MusaAkyuz/8bit-Computer/hardware/03-revision-2023/ControlÜnitesiMalzemeler.pdf

## Bill Of Materials for ControlBlock

Design Title | ControlBlock

### Author Document Number Revision

Design Created | 02 May 2023

### Design Last Modified 02 May 2023 Total Parts In Design 44

0 Modules
Quantity | References | Value | Stock Code | Unit Cost
Sub-totals: | | | | £0.00
0 Capacitors
Quantity | References | Value | Stock Code | Unit Cost
Sub-totals: | | | | £0.00
0 Resistors
Quantity | References | Value | Stock Code | Unit Cost
Sub-totals: | | | | £0.00
44 Integrated Circuits
Quantity | References | Value | Stock Code | Unit Cost
7 | U1-U7 | NOT
9 | U8,U19-U26 | AND_5
13 | U9-U13,U16,U27-U30,U38-U40 | AND_3
2 | U14,U32 | OR_5
4 | U15,U33,U35,U43 | AND
4 | U17-U18,U31,U41 | AND_4
4 | U34,U36-U37,U44 | OR
1 | U42 | OR_4
Sub-totals: | | | | £0.00
0 Transistors
Quantity | References | Value | Stock Code | Unit Cost
Sub-totals: | | | | £0.00
0 Diodes
Quantity | References | Value | Stock Code | Unit Cost
Sub-totals: | | | | £0.00
0 Miscellaneous
Quantity | References | Value | Stock Code | Unit Cost
Sub-totals: | | | | £0.00
Totals: | | | | £0.00
| | | | 02 May 2023 13:30:44
