MusaAkyuz/8bit-Computer/docs/paper/bildiri-yedek-template.docx

8-Bit Bilgisayar Mimarisi ve Komut Seti Tasarımı ve Gerçekleştirilmesi

8-Bit Computer Architecture and Instruction Set Desing and Implementation

Musa Akyüz, Dr. Öğr. Üyesi Ümit Şentürk

Özetçe—Günümüzde, birçok işlemci üreten firma ve bu firmaların arasındaki rekabete baktığımızda hepsinin daha küçük alanda daha hızlı işler yaptıran elektronik devreler üretmeye çalıştığını görüyoruz. Bu çalışmada, nanometreler düzeyinde yapılan yarışın, büyük hale dönüştürülmüş versiyonu tanıtılmaktadır. Bu çalışma, işlemci içerisindeki mantıksal ve aritmatik hesaplama, kaydetme, giriş-çıkış ve kaydırma birimlerinin basit elektronik elemanlar ve tümleşik devreler ile tasarımını ve birimlerin birbirleriyle senkronize şekilde haberleşmesini içermektedir. Tasarlanan komut seti sayesinde bu birimlerin bit düzeyindeki işlemleri kontrol edilmektedir. 8 bit veri yollu tek vuruşluk işlemci tasarlanmıştır. Hafıza birimi işlemci içerisinde konumlandırılmıştır. Bu sayede günümüz işlemcilerinin bir dezavantajı olan hafıza biriminden veri işleme süresi ve gecikmesinin önüne geçilmeye çalışılmıştır.

Anahtar Kelimeler — bilgisayar mimarisi; komut seti; aritmatik mantık birimi; kaydedici; veri yolu tasarımı;

Abstract—This electronic document is a “live” template and already defines the components of your paper [title, text, heads, etc.] in its style sheet. *CRITICAL: Do Not Use Symbols, Special Characters, or Math in Paper Title or Abstract.

Keywords — computer architecture; ınstruction set; arithmetic logic unit; register; bus design

# I. Giriş

Tasarlanan mimaride Harward mimarisi benimsenmiştir. Harward mimarisi program belleği ile veri belleğinin farklı veri yolları ile merkezi işlem birimine bağlı olduğu mimaridir [1]. Komut ve veri bilgisi aynı anda merkezi işlem birimine gelebildiği için bir komut tek vuruşta işlenebilir [2]. Bu tasarım işlemci içersindeki veri yollarının sayısını arttırır. Bu sayede kontrol ünitesinin çok daha basit bir sistem olmasını sağlamaktadır.Benzer bir araştırmaya [3] kıyasla Tasarlanan komut seti içeriğinde, komutun kendisi ve kontrol ünitesi için kullanılacak bitler, manuel olarak veri girişi için anlık değer bitleri ve kaydediciler için adres bitleri bulunur. Her bir komut 24 bit uzunluğundadır ve tek türdür.

# II. Method

TABLO I.  24 bit komut için bit dağılımı

Komut Seti | Bit dağılımı
| 7-bit | 9-bit (3-3-3) | | | 8-bit
| Kontrol ünitesi – Komut bilgisi | HK | KK1 | KK2 | Anlık değer

a. HK: Hedef Kaydedici Adresi, KK: Kaynak Kaydedici Adresi

Tablo 1’de de görüleceği üzere 7-bit ile komut tespiti yapılmıştır. Tasarlanan mimaride 2^7 yani 128 farklı komut çalıştırılabilir. Şimdilik, 28 farklı temel komut oluşturulmuştur.

TABLO II.  Aritmatik- Mantıksal Komutlar

Komut Türleri | Komutlar
Aritmatik Komutlar | ADD, ADDIMM, SUB, SUBIMM
Mantıksal Komutlar | AND ANDIMM, OR, ORIMM

Tablo 2 de 4 adet aritmatik işlem ve 4 adet de mantıksal işlem komutları bulunmaktadır. Aritmatikler sırasıyla toplama, anlık ile toplama, çıkarma, anlık ile çıkarma, ve işlemidir. Mantıksa komutlar sırasıyla ve, anlık ile ve, veya, anlık ile veya işlemidir.

Örnek olarak; kaynak kaydedi 2 (adresi 010) içerisinde 8 bit uzunluğunda 125 verisini tutsun. Hedef kaydedici 5 (adresi 101) de üzerinde 8 bit ile 12 bilgisini tutsun. Bu iki veriyi aritmatik mantık birimindeki toplayıcı devre üzerinde toplayıp çıkışı 1 nolu kaydediciye (adresi 001) kaydedeceği bir senaryo olsun. Program belleğinden ADD komutu (komut kodu 0000001) bu bilgilerle birlikte şu şekilde gelecektir.

000000100101010100000000

Anlık

değer

KY2

KY1

HY

Komut kodu

TABLO III.  Kaydırma

Komut Türleri | Komutlar
Kaydırma | SHIFTLEFT, SHIFTRIGHT

Tablo 3 de birer bit sola ve sağa kaydırma komutları görülür. Tasarlanan komut setinde birden çok kaydırma adımı içiren bir sistem olması durumunda bu komutlar ard arda çalışacaktır.

TABLO IV.  Kaydedici kayıt

Komut Türleri | Komutlar
Anlık değerden alma | LBFROMIMM
Bellekten alma | LBFROMMEM
Başka bir kaydediciden alma | REGTOREG

Tablo 4 deki komutlar, kaydedicilere ilk değer atanırken veya bellekten çekilen verinin kaydedicilere geçirilmesi esnasında kullanılırlar.

Örnek olarak; 5 nolu kaydediciden (adresi 101) 2 numaralı kaydediciye (adresi 010) içerisindeki veriyi kaydetmek isteyelim. Bu bilgilerle birlikte REGTOREG komutu (komut kodu 0001101) şu şekilde yazılır.

000110110100001000000000

TABLO V.  Hafıza işlemleri

Komut Türleri | Komutlar
Kayıt etme | SBFROMIMM, SBFROMREG

Tabla 5 deki komutlar anlık değerden veya kaydediciden aldığı bellekteki adres bilgisine, yine anlık değerden veya kaydediciden aldığı bilgiyi kaydeder.

TABLO VI.  Dallanma komutları

Komut Türleri | Komutlar
Dallanma | BEQ, BNE, BLT, BGT, BGE, BLE

Tablo 6 daki komutlar, program devam ederken gelen atlama işlemi komutlarıdır. Bu komutlar iki kaydedicinin verisini karşılaştıraraki büyüklük, küçüklük ve eşitlik durumlarına göre program sayacının akışını değiştirirler. Bu sayede programda döngü yazılabilir hale gelir.

Tablo 7 de ise giriş çıkış için kullanılacak komutlar vardır. Herhangi bir kaydedicideki veya bellekteki bir veriyi, farklı adresleme metodları ile çıkış ünitesine gönderen komutların yanı sıra, giriş olarak işleyen ve kaydeden komutlardır.

TABLO VII.  Giriş – Çıkış komutları

Komut Türleri | Komutlar
Çıkış | PRINTREG, PRINTREGANDLOAD, PRINTMEMFROMREG, PRINTMEMFROMIMM
Giriş | WRITETOREG, WRITETIMEMFROMREG, WRITETIMEMFROMIMM


Figure. 1. Advanced diagram to design

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

Program sayıcıda hesaplanan komut adresi, komut belleğinde bulunan 3 farklı 8 bit adreslenebilir belleklerin adres seçim pinleri ile bağlanır. Burada 3 farklı bellek kullanımının amacı, paralel veri yolu sistemini korumak ve kontrol unitesinin karmaşıklığını azaltmaktır (Bkz Figure 2).


Figure. 2. Program Memory Split Structure Basic Schema

Bu [4] yazıda bahsi geçen Single Instruction Multiple Data Stream yaklaşımı gibi program sayacı ile birden çok bellekden (SIMD) veri çıkışı kontrol edilmiştir.


Figure. 3. Input-Output design

Figure 3 deki resimde görüleceği üzere, giriş çıkış ünitesi doğrudan tasarlanan işlemcinin içindeki ortak veri yoluna bağlıdır. Kontrol ünitesinden gelen giriş veya çıkış işlemleri sırasında bu veri yollarından veri çekere veya veriyi aktarır.

# III. Kullanım

## A. Taslak seçmek (*Heading 2)

Doğru taslağı (bu taslağı) kullandığınızdan emin olunuz.

## B. Taslağın formatına bağlı kalmak

Taslağın formatını değiştirmeyiniz. Bu yayın tek başına bir doküman değildir, bir derginin parçası olarak basılacaktır.

# IV. Sayfa Düzeni ve Biçim

Düzenlemeye başlamadan önce tüm çalışmanızı ayrı bir dosya olarak kayıdetmeniz tavsiye edilir. Ayrıca düzenleme sonuçlanıncaya kadar grafik ve şekilleri düz yazıdan ayrı tutmanız faydalı olacaktır. Çalışmanın herhangi bir noktasında sayfa numaralandırması yapılmamalıdır. Taslak içerisinde başlıklar numaralandırılacağından ayrıca sizin numaralandırmanıza gerek yoktur. Sayfa düzenlenirken aşağıdaki kurallara uyulmalıdır. Hazır bir taslak (Word ya da LaTeX) kullanmanız veya ayrıntıların kontrolü için örnek bir dosya takip etmeniz, bu gereklilikleri yerine getirmeniz açısından önerilir.

İlgili bölümlerde kullanılması gereken stiller parantez içerisinde eğik yazı ile belirtilmiştir, ”(*kullanılacak stil)” şeklinde. Bu ifadeler sadece bilgilendirme amaçlıdır, metnin son halinde bulunmamalıdır.

## A. Kısaltmalar

Kısaltmaları yazı içinde ilk defa kullanıldıklarında tanımlayınız. Başlıklarda kısaltma kullanmayınız. IEEE, SI, CGS vb. gibi çok bilinmiş kısaltmaları tanımlamanıza gerek yoktur.

## B. Birimler

- SI veya CGS ölçüm birimlerini kullanınız. (SI ölçüm birimi tavsiye edilir.)
- Yazı içinde farklı ölçüm birimleri kullanmayınız. İngiliz ölçüm birimlerini birinci birim olarak kullanmaktan kaçınınız. Ancak çok gerekli ise parantez içerisinde ikinci birim olarak gösteriniz.
- Ölçüm birimlerini yazarken tutarlılık sağlayınız. Örneğin “Wb/m²” veya “webers per square meter” kullanınız, “webers/m²” kullanmayınız.
- Küsuratlı sayı kullanırken “.25” yerine “0.25” kullanınız.

## C. Denklemler

Denklemler taslaktaki formata istisnadır. “Times New Roman” veya “Symbol” yazı tipini kullanınız. Çok seviyeli denklemleri resim olarak yazıya yerleştiriniz.

Denklemler aşağıdaki örneğe benzemelidir. Denklemler için “*equation” stilini kullanınız.

ab

Denklem merkezde olmalıdır. Denklemdeki sembolleri tanımladığınızdan emin olunuz. Denklemden bahsederken “(1)” kullanınız. Cümle başında “Denklem (1)” kullanabilirsiniz.

# V. Taslağı Kullanmak

## A. Yazarlar

Yayının yazarları bildiri kabulünden sonra gönderilecek son halinde bu taslağın başında “Yazarlar Gizlenmiştir” ibaresinin olduğu yerde belirtilecek ve yazar, kurum ve iletişim bilgileri bu ibarenin alt satırlarında belirtilecektir. Aynı kurumda çalışan yazarları sırf farklı bölümde çalışıyorlar diye farklı olarak belirtmeye gerek olmayacaktır. **Ancak bildirinin ilk gönderilecek halinde yazarların kimliğini açığa çıkarıcı hiçbir bilgi bulunmamalıdır.

## B. Başlıklar

Bölüm başlıkları için “Başlık 1 (Heading 1)” kullanınız. Şekiller için “şekil başlığı (figure caption)”, tablolar için ise “Tablo Başlığı (table head)” kullanınız.

Eğer birden fazla alt konu yoksa alt konu başlığı kullanmayınız.

## C. Şekil ve Tablolar

### 1) Şekil ve tabloların yerleştirilmeleri: (*Heading 3) Şekilleri ve tabloları metinde isimleri geçtikten sonra sütun başına veya sonuna yerleştiriniz. Şekil başlığını şeklin altına, tablo başlığını ise tablonun üstüne yerleştiriniz. Tablo örneği Tablo 1’de ve şekil örneği Şekil 1’de gösterilmiştir.

### 2) Aksis tanımlamaları: 8 büyüklüğünde punto kullanınız. Kısaltma kullanmayınız. Birim ekleyecekseniz “Sıcaklık/K” değil, “Sıcaklık (K)” şeklinde olmalıdır.

Şekil. 1. Şekil örneği. (*figure caption)

Şekillerin bir metin dosyasının içinde olması dosyanın daha kararlı olmasını sağladığı gözlenmiştir. (Bir görselin ideal olarak 300dpi çözünürlüklü TIFF veya EPS dosyası olması ve bütün yazı tiplerinin gömülü olması beklenmektedir.)

Metin kutusunun “Renk ve Çizgi” ayarlarından çerçeve renksiz ve çizgisiz hale getirilebilir.

TABLO VIII.  Örnek Tablo (*table head)

Tablo Başlığı | Tablo Sütun Başlığı
| Tablo sütun ara başlığıa | Ara başlık | Ara başlık

b. Tablo dipnotu örneği. (*table footnote)

##### Bilgilendirme

Bilgilendirmeler gizlenmiştir.

##### Kaynaklar

[1] Pizhou Ye and Chaodong Ling, "A RISC CPU IP core," 2008 2nd International Conference on Anti-counterfeiting, Security and Identification, 2008, pp. 356-359, doi: 10.1109/IWASID.2008.4688427.
[2] Reaz, M. I., Jalil, J., & Rahman, L. F. (2012). Single core hardware modeling of 32-bit MIPS RISC processor with a single clock. Research Journal of Applied Sciences, Engineering and Technology, 4(7), 825-832.
[3] Özkurt, N. E. & Gündüzalp, M. (2000). 8 BİT GENEL AMAÇLI BİR MİKRODENETLEYİCİNİN ÇOK BÜYÜK ÖLÇEKLİ TÜMLEŞİK DEVRE TEKNOLOJİSİ İLE TASARIMI . Dokuz Eylül Üniversitesi Mühendislik Fakültesi Fen ve Mühendislik Dergisi , 2 (2) , 1-14 . Retrieved from https://dergipark.org.tr/tr/pub/deumffmd/issue/40893/493747
[4] Flynn, Michael J., and Kevin W. Rudd. "Parallel architectures." ACM computing surveys (CSUR) 28.1 (1996): 67-70.
[5] Rudnicky, A. I., Polifroni, Thayer, E H., and Brennan, R. A. "Interactive problem solving with speech", J. Acoust. Soc. Amer., Vol. 84, 1988, p S213(A).
