MusaAkyuz/8bit-Computer/docs/design/komutseti.ods

 |  |  | 7 BİT | 3BİT | 3 BİT |  | 3 BİT |  | 8 BİT
 | Komut | Açıklama | Kontrol Ünitesi Kodu | HY | KY1 |  | KY2 |  | Anlık Değer | Açıklama
1 | ADD | İki kaydedicideki veriyi toplar | 0000001 | √ | √ |  | √ |  | X | HY = KY1 + KY2
2 | ADDIMM | Bir kaydedicideki veri ile anlık değeri toplar | 0000010 | √ | √ |  | X |  | √ | HY = KY1 + ANLIK
3 | SUB | İki kaydedicideki veriyi çıkarır | 0000011 | √ | √ |  | √ |  | X | HY = KY1 – KY2
4 | SUBIMM | Bir kaydedicideki veriden anlık değeri çıkarır | 0000100 | √ | √ |  | X |  | √ | HY = KY1 – ANLIK
5 | AND | İki kaydedicideki verileri VE işlemine sokar | 0000101 | √ | √ |  | √ |  | X | HY = KY1 && KY2
6 | ANDIMM | Bir kaydedicideki veri ile anlık değeri VE işlemine sokar | 0000110 | √ | √ |  | X |  | √ | HY = KY1 && ANLIK
7 | OR | İki kaydedicideki verileri VEYA işlemine sokar | 0000111 | √ | √ |  | √ |  | X | HY = KY1 || KY2
8 | ORIMM | Bir kaydedicideki veri ile anlık değeri VEYA işlemine sokar | 0001000 | √ | √ |  | X |  | √ | HY = KY1 || ANLIK
9 | SHIFTLEFT | Bir kaydedicideki veriyi bir BİT sola kaydırır | 0001001 | √ | KAYDEDİCİ3 |  | X |  | X | HY = KY1[0:6]
10 | SHIFTRIGHT | Bir kaydedicideki veriyi bir BİT sağa kaydırı | 0001010 | √ | KAYDEDİCİ 3 |  | X |  | X | HY = KY1[1:7]
11 | LBFROMIMM | Anlık değerden aldığı veriyi hedef kaydediciye yükler | 0001011 | √ | X |  | X |  | √ | HY = ANLIK
12 | LBFROMMEM | Hafızadan aldığı veriyi hedef kaydediciye yükler, Hafıza adreslerken anlık değeri kullanır | 0001100 | √ | X |  | X |  | √ | HY = MEM(ANLIK)
13 | REGTOREG | Bir kaydedicideki veriyi başka bir kaydediciye aktarır, yükler | 0001101 | √ | √ | X | X | √ | X | HY = KY
14 | SBFROMIMM | Bir kaydedicideki veriyi adres olarak kullanır ve hafıza birimine anlık değeri yazar | 0001110 | X | √ | X | X | √ | √ | MEM(KY) = ANLIK
15 | SBFROMREG | Anlık değerdeki veriyi adres olarak kullanır ve hafıza birimine kaydedicideki veriyi yazar | 0001111 | X | √ | X | X | √ | √ | MEM(ANLIK) = KY
16 | BEQ | İki kaydedicideki verinin eşit olma durumunu karşılaştırır. Eğer eşitse anlık değer kadar komut atlar | 0010000 | X | √ |  | √ |  | √ | IF KY1 == KY2 JUMP ANLIK
17 | BNE | İki kaydedicideki verinin eeşit olmama durumunu karşılaştırır. Eşit değilse anlık değer kadar komut atlar | 0010001 | X | √ |  | √ |  | √ | IF KY1 != KY2 JUMP ANLIK
18 | BLT | Birinci kaydedicideki verinin ikinci kaydedicideki veriden küçük olma durumunu karşılaştırır. Eğer büyükse, anlık değer kadar komut atlar | 0010010 | X | √ |  | √ |  | √ | IF KY1 < KY2 JUMP ANLIK
19 | BGT | Birinci kaydedicideki verinin ikinci kaydedicideki veriden büyük olma durumunu karşılaştırır. Eğer büyükse, anlık değer kadar komut atlar | 0010011 | X | √ |  | √ |  | √ | IF KY1 > KY2 JUMP ANLIK
20 | BGE | Birinci kaydedicideki verinin ikinci kaydedicideki veriden büyük ve eşit olma durumunu karşılaştırır. Eğer büyük ve eşitse, anlık değer kadar komut atlar | 0010100 | X | √ |  | √ |  | √ | IF KY1 >= KY2 JUMP ANLIK
21 | BLE | Birinci kaydedicideki verinin ikinci kaydedicideki veriden küçük ve eşit olma durumunu karşılaştırır. Eğer kü.ük ve eşit ise, anlık değer kadar komut atlar | 0010101 | X | √ |  | √ |  | √ | IF KY1 <= KY2 JUMP ANLIK
22 | PRINTREG | Bir kaydedicideki veriyi çıkış birimine gönderir | 0010110 | X | √ | X | X | √ | X | OUTPUT(KY)
23 | PRINTREGANDLOAD | Bir kaydedicideki veriyi çıkış birimine gönderir ve başka bir kaydediciye yükler | 0010111 | √ | √ | X | X | √ | X | HY = OUTPUT(KY)
24 | PRINTMEMFROMREG | Bir kaydedicideki veriyi adres olarak kullanır ve hafıza birimine gönderir. O adresdeki veriyi çıkış birimine gönderir | 0011000 | X | √ | X | X | √ | X | OUTPUT(MEM(KY))
25 | PRINTMEMFROMIMM | Anlık değeri adres olarak kullanır ve hafıza birimine gönderir. O adresdeki veriyi çıkış birimine gönderir | 0011001 | X | X |  | X |  | √ | OUTPUT(MEM(ANLIK))
26 | WRITETOREG | Giriş biriminden gelen veriyi bir kaydediciye yükler | 0011010 | √ | X |  | X |  | X | HY = INPUT
27 | WRITETOMEMFROMREG | Bir kaydedicideki veriyi adres olarak kullanır ve giriş biriminden gelen veriyi hafıza birimine yükler | 0011011 | X | √ | X | X | √ | X | MEM(KY) = INPUT
28 | WRITETOMEMFROMIMM | Anlık değerden aldığı veriyi adres olarak kullanır ve giriş biriminden aldığı veriyi hafıza birimine yükler | 0011100 | X | X |  | X |  | √ | MEM(ANLIK) = INPUT
