MusaAkyuz/8bit-Computer/docs/images/proteus-overview.png

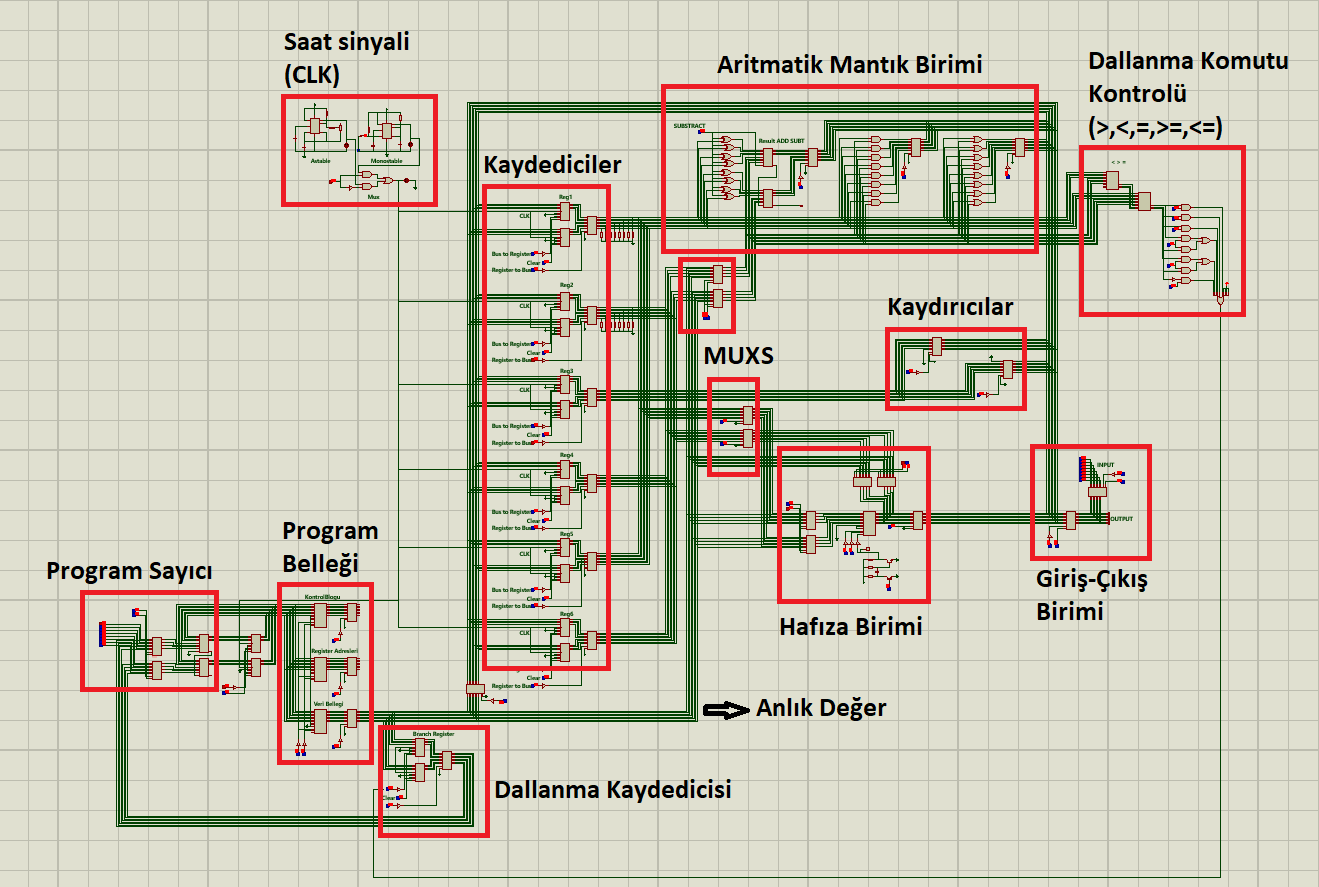
docs/images/proteus-overview.png
