MusaAkyuz/8bit-Computer/docs/images/reference-avr-arithmetic.png

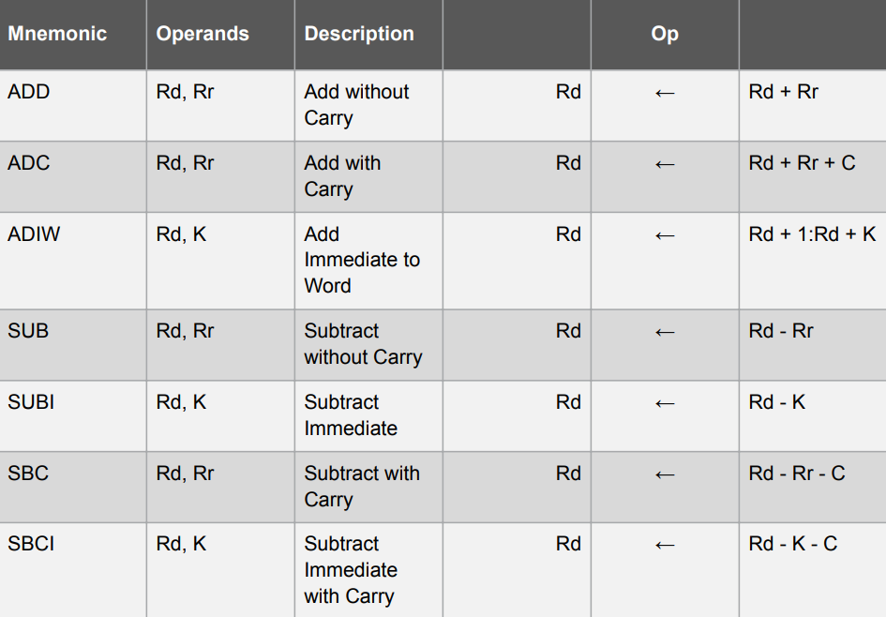
docs/images/reference-avr-arithmetic.png
