MusaAkyuz/8bit-Computer/docs/images/reference-intel-8080.png

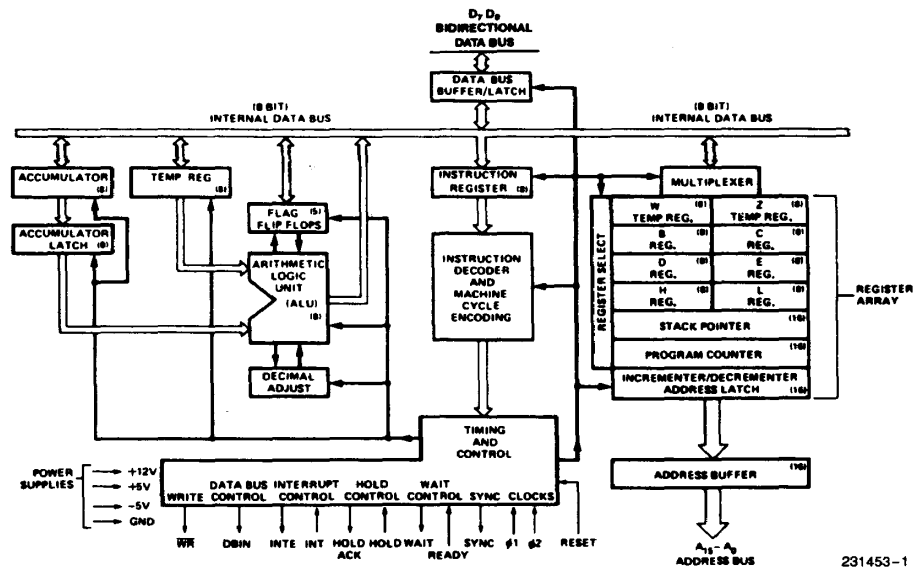
docs/images/reference-intel-8080.png
