MusaAkyuz/8bit-Computer/docs/design/komutseti-aktarma.xlsx

Sheet: Komut_Seti_V1
 |  |  | 7 BİT | 3BİT | 3 BİT |  | 3 BİT |  | 8 BİT
 | Komut | Açıklama | Kontrol Ünitesi Kodu | HY | KY1 |  | KY2 |  | Anlık Değer | Açıklama
1 | ADD | İki kaydedicideki veriyi toplar | 0000001 | √ | √ |  | √ |  | X | HY = KY1 + KY2
2 | ADDIMM | Bir kaydedicideki veri ile anlık değeri toplar | 0000010 | √ | √ |  | X |  | √ | HY = KY1 + ANLIK
3 | SUB | İki kaydedicideki veriyi çıkarır | 0000011 | √ | √ |  | √ |  | X | HY = KY1 – KY2
4 | SUBIMM | Bir kaydedicideki veriden anlık değeri çıkarır | 0000100 | √ | √ |  | X |  | √ | HY = KY1 – ANLIK
5 | AND | İki kaydedicideki verileri VE işlemine sokar | 0000101 | √ | √ |  | √ |  | X | HY = KY1 && KY2
6 | ANDIMM | Bir kaydedicideki veri ile anlık değeri VE işlemine sokar | 0000110 | √ | √ |  | X |  | √ | HY = KY1 && ANLIK
7 | OR | İki kaydedicideki verileri VEYA işlemine sokar | 0000111 | √ | √ |  | √ |  | X | HY = KY1 || KY2
8 | ORIMM | Bir kaydedicideki veri ile anlık değeri VEYA işlemine sokar | 0001000 | √ | √ |  | X |  | √ | HY = KY1 || ANLIK
9 | SHIFTLEFT | Bir kaydedicideki veriyi bir BİT sola kaydırır | 0001001 | √ | KAYDEDİCİ3 |  | X |  | X | HY = KY1[0:6]
10 | SHIFTRIGHT | Bir kaydedicideki veriyi bir BİT sağa kaydırı | 0001010 | √ | KAYDEDİCİ 3 |  | X |  | X | HY = KY1[1:7]
11 | LBFROMIMM | Anlık değerden aldığı veriyi hedef kaydediciye yükler | 0001011 | √ | X |  | X |  | √ | HY = ANLIK
12 | LBFROMMEM | Hafızadan aldığı veriyi hedef kaydediciye yükler, Hafıza adreslerken anlık değeri kullanır | 0001100 | √ | X |  | X |  | √ | HY = MEM(ANLIK)
13 | REGTOREG | Bir kaydedicideki veriyi başka bir kaydediciye aktarır, yükler | 0001101 | √ | √ | X | X | √ | X | HY = KY
14 | SBFROMIMM | Bir kaydedicideki veriyi adres olarak kullanır ve hafıza birimine anlık değeri yazar | 0001110 | X | √ | X | X | √ | √ | MEM(KY) = ANLIK
15 | SBFROMREG | Anlık değerdeki veriyi adres olarak kullanır ve hafıza birimine kaydedicideki veriyi yazar | 0001111 | X | √ | X | X | √ | √ | MEM(ANLIK) = KY
16 | BEQ | İki kaydedicideki verinin eşit olma durumunu karşılaştırır. Eğer eşitse anlık değer kadar komut atlar | 0010000 | X | √ |  | √ |  | √ | IF KY1 == KY2 JUMP ANLIK
17 | BNE | İki kaydedicideki verinin eeşit olmama durumunu karşılaştırır. Eşit değilse anlık değer kadar komut atlar | 0010001 | X | √ |  | √ |  | √ | IF KY1 != KY2 JUMP ANLIK
18 | BLT | Birinci kaydedicideki verinin ikinci kaydedicideki veriden küçük olma durumunu karşılaştırır. Eğer büyükse, anlık değer kadar komut atlar | 0010010 | X | √ |  | √ |  | √ | IF KY1 < KY2 JUMP ANLIK
19 | BGT | Birinci kaydedicideki verinin ikinci kaydedicideki veriden büyük olma durumunu karşılaştırır. Eğer büyükse, anlık değer kadar komut atlar | 0010011 | X | √ |  | √ |  | √ | IF KY1 > KY2 JUMP ANLIK
20 | BGE | Birinci kaydedicideki verinin ikinci kaydedicideki veriden büyük ve eşit olma durumunu karşılaştırır. Eğer büyük ve eşitse, anlık değer kadar komut atlar | 0010100 | X | √ |  | √ |  | √ | IF KY1 >= KY2 JUMP ANLIK
21 | BLE | Birinci kaydedicideki verinin ikinci kaydedicideki veriden küçük ve eşit olma durumunu karşılaştırır. Eğer kü.ük ve eşit ise, anlık değer kadar komut atlar | 0010101 | X | √ |  | √ |  | √ | IF KY1 <= KY2 JUMP ANLIK
22 | PRINTREG | Bir kaydedicideki veriyi çıkış birimine gönderir | 0010110 | X | √ | X | X | √ | X | OUTPUT(KY)
23 | PRINTREGANDLOAD | Bir kaydedicideki veriyi çıkış birimine gönderir ve başka bir kaydediciye yükler | 0010111 | √ | √ | X | X | √ | X | HY = OUTPUT(KY)
24 | PRINTMEMFROMREG | Bir kaydedicideki veriyi adres olarak kullanır ve hafıza birimine gönderir. O adresdeki veriyi çıkış birimine gönderir | 0011000 | X | √ | X | X | √ | X | OUTPUT(MEM(KY))
25 | PRINTMEMFROMIMM | Anlık değeri adres olarak kullanır ve hafıza birimine gönderir. O adresdeki veriyi çıkış birimine gönderir | 0011001 | X | X |  | X |  | √ | OUTPUT(MEM(ANLIK))
26 | WRITETOREG | Giriş biriminden gelen veriyi bir kaydediciye yükler | 0011010 | √ | X |  | X |  | X | HY = INPUT
27 | WRITETOMEMFROMREG | Bir kaydedicideki veriyi adres olarak kullanır ve giriş biriminden gelen veriyi hafıza birimine yükler | 0011011 | X | √ | X | X | √ | X | MEM(KY) = INPUT
28 | WRITETOMEMFROMIMM | Anlık değerden aldığı veriyi adres olarak kullanır ve giriş biriminden aldığı veriyi hafıza birimine yükler | 0011100 | X | X |  | X |  | √ | MEM(ANLIK) = INPUT

Sheet: Komut_Seti_V2
 |  |  | 7 BİT | 3BİT | 3 BİT | 3 BİT | 8 BİT
 | Komut | Açıklama | Kontrol Ünitesi Kodu | HY | KY1 | KY2 | Anlık Değer | Açıklama
1 | ADD | İki kaydedicideki veriyi toplar | 0000001 | √ | √ | √ | X | HY = KY1 + KY2
2 | ADDIMM | İlk kaydedicideki veri ile anlık değeri toplar | 0000010 | √ | √ | X | √ | HY = KY1 + ANLIK
3 | SUB | İlk kaydediciden ikinci kaydediciyi çıkarır. | 0000011 | √ | √ | √ | X | HY = KY1 – KY2
4 | SUBIMM | İlk kaydedicideki veriden anlık değeri çıkarır | 0000100 | √ | √ | X | √ | HY = KY1 – ANLIK
5 | AND | İki kaydedicideki verileri VE işlemine sokar | 0000101 | √ | √ | √ | X | HY = KY1 && KY2
6 | ANDIMM | İlk kaydedicideki veri ile anlık değeri VE işlemine sokar | 0000110 | √ | √ | X | √ | HY = KY1 && ANLIK
7 | OR | İki kaydedicideki verileri VEYA işlemine sokar | 0000111 | √ | √ | √ | X | HY = KY1 || KY2
8 | ORIMM | İki kaydedicideki veri ile anlık değeri VEYA işlemine sokar | 0001000 | √ | √ | X | √ | HY = KY1 || ANLIK
9 | SHIFTLEFT | İlk kaydedicideki veriyi bir BİT sola kaydırır | 0001001 | √ | √ | X | X | HY = KY1[0:6]
10 | SHIFTRIGHT | İlk kaydedicideki veriyi bir BİT sağa kaydırı | 0001010 | √ | √ | X | X | HY = KY1[1:7]
11 | IMMTOREG | Anlık değerden aldığı veriyi hedef kaydediciye yükler | 0001011 | √ | X | X | √ | HY = ANLIK
12 | MEMTOREG | Hafızadan aldığı veriyi hedef kaydediciye yükler, Hafıza adreslerken anlık değeri kullanır | 0001100 | √ | X | X | √ | HY = MEM(ANLIK)
13 | REGTOREG | İkinci kaydedicideki veriyi hedef kaydediciye aktarır | 0001101 | √ | X | √ | X | HY = KY2
14 | REGTOMEM | Anlık değerdeki veriyi adres olarak kullanır ve hafıza birimine ikinci kaydedicideki veriyi yazar | 0001110 | X | √ | X | √ | MEM(ANLIK) = KY2
15 | BEQ | İki kaydedicideki verinin eşit olma durumunu karşılaştırır. Eğer eşitse anlık değer kadar komut atlar | 0001111 | X | √ | √ | √ | IF KY1 == KY2 JUMP ANLIK
16 | BNE | İki kaydedicideki verinin eeşit olmama durumunu karşılaştırır. Eşit değilse anlık değer kadar komut atlar | 0010000 | X | √ | √ | √ | IF KY1 != KY2 JUMP ANLIK
17 | BLT | Birinci kaydedicideki verinin ikinci kaydedicideki veriden küçük olma durumunu karşılaştırır. Eğer büyükse, anlık değer kadar komut atlar | 0010001 | X | √ | √ | √ | IF KY1 < KY2 JUMP ANLIK
18 | BGT | Birinci kaydedicideki verinin ikinci kaydedicideki veriden büyük olma durumunu karşılaştırır. Eğer büyükse, anlık değer kadar komut atlar | 0010010 | X | √ | √ | √ | IF KY1 > KY2 JUMP ANLIK
19 | BGE | Birinci kaydedicideki verinin ikinci kaydedicideki veriden büyük ve eşit olma durumunu karşılaştırır. Eğer büyük ve eşitse, anlık değer kadar komut atlar | 0010011 | X | √ | √ | √ | IF KY1 >= KY2 JUMP ANLIK
20 | BLE | Birinci kaydedicideki verinin ikinci kaydedicideki veriden küçük ve eşit olma durumunu karşılaştırır. Eğer kü.ük ve eşit ise, anlık değer kadar komut atlar | 0010100 | X | √ | √ | √ | IF KY1 <= KY2 JUMP ANLIK
21 | PRINTREG | İkinci kaydedicideki veriyi çıkış birimine gönderir | 0010101 | X | X | √ | X | OUTPUT(KY2)
22 | IMMTOPRINTMEM | Anlık değeri adres olarak kullanır ve hafıza birimine gönderir. O adresdeki veriyi çıkış birimine gönderir | 0010110 | X | X | X | √ | OUTPUT(MEM(ANLIK))
23 | WRITEREG | Giriş biriminden gelen veriyi bir kaydediciye yükler | 0010111 | √ | X | X | X | HY = INPUT
24 | IMMTOWRITEMEM | Anlık değerden aldığı veriyi adres olarak kullanır ve giriş biriminden aldığı veriyi hafıza birimine yükler | 0011000 | X | X | X | √ | MEM(ANLIK) = INPUT
25 | CLEARALLREG | Tüm kaydedicilerin verilerini sıfırlar | 0011001 | X | X | X | X | ALLREG = 0
26 | CLEARSPECREG | İlgili kaydedicinin verisini siler | 0011010 | X | √ | X | X | REG = 0
 |  | İlk Kaydedici -> KY1
 |  | İkinci Kaydedici -> KY2
 |  | Hedef Kaydedici -> HY

Sheet: KARNOUGH_V1
Kaurnaugh Map | Counter | Branch Register |  | Immediatelly to Register | MUX1 REGTOIMM | MUX2 REGTOIMM2 |  | ALU |  |  |  |  |  |  |  |  |  |  |  | Memory |  |  | Memory Buffer |  | In/Out
Command/Inputs | SLC | E | BUFFBRNC | ITR | REGTOIMM1 | REFTOIMM2 | E-MEM-D | ADD/SUBB | BUFFADD/SUB | BUFAND | BUFOR | BUFSR | BUFSL | LESS | EQ | BIGGER | LESSEQ | BIGEQ | NOTEQ | E | R | W | MIN/MOUT | Enable Buf. | EnableIn | LCD/D
ADD | 0 | 0 | 0 | 0 | 0 | X | X | 0 | 1 | 0 | 0 | 0 | 0 | 0 | 0 | 0 | 0 | 0 | 0 | 0 | X | X | X | 0 | 0 | 1
ADDIMM | 0 | 0 | 0 | 0 | 1 | X | X | 0 | 1 | 0 | 0 | 0 | 0 | 0 | 0 | 0 | 0 | 0 | 0 | 0 | X | X | X | 0 | 0 | 1
SUB | 0 | 0 | 0 | 0 | 0 | X | X | 1 | 1 | 0 | 0 | 0 | 0 | 0 | 0 | 0 | 0 | 0 | 0 | 0 | X | X | X | 0 | 0 | 1
SUBIMM | 0 | 0 | 0 | 0 | 1 | X | X | 1 | 1 | 0 | 0 | 0 | 0 | 0 | 0 | 0 | 0 | 0 | 0 | 0 | X | X | X | 0 | 0 | 1
AND | 0 | 0 | 0 | 0 | 0 | X | X | X | 0 | 1 | 0 | 0 | 0 | 0 | 0 | 0 | 0 | 0 | 0 | 0 | X | X | X | 0 | 0 | 1
ANDIMM | 0 | 0 | 0 | 0 | 1 | X | X | X | 0 | 1 | 0 | 0 | 0 | 0 | 0 | 0 | 0 | 0 | 0 | 0 | X | X | X | 0 | 0 | 1
OR | 0 | 0 | 0 | 0 | 0 | X | X | X | 0 | 0 | 1 | 0 | 0 | 0 | 0 | 0 | 0 | 0 | 0 | 0 | X | X | X | 0 | 0 | 1
ORIMM | 0 | 0 | 0 | 0 | 1 | X | X | X | 0 | 0 | 1 | 0 | 0 | 0 | 0 | 0 | 0 | 0 | 0 | 0 | X | X | X | 0 | 0 | 1
SHIFTLEFT | 0 | 0 | 0 | 0 | 0 | X | X | X | 0 | 0 | 0 | 0 | 1 | 0 | 0 | 0 | 0 | 0 | 0 | 0 | X | X | X | 0 | 0 | 1
SHIFTRIGHT | 0 | 0 | 0 | 0 | 0 | X | X | X | 0 | 0 | 0 | 1 | 0 | 0 | 0 | 0 | 0 | 0 | 0 | 0 | X | X | X | 0 | 0 | 1
LBFROMIMM | 0 | 0 | 0 | 1 | X | X | X | X | 0 | 0 | 0 | 0 | 0 | 0 | 0 | 0 | 0 | 0 | 0 | 0 | X | X | X | 0 | 0 | 1
LBFROMMEM | 0 | 0 | 0 | 0 | 1 | X | 0 | X | 0 | 0 | 0 | 0 | 0 | 0 | 0 | 0 | 0 | 0 | 0 | 1 | 1 | 0 | 1 | 1 | 0 | 1
REGTOREG | 0 | 0 | 0 | 0 | 1 | J | J | X | 0 | 0 | 0 | 0 | 0 | 0 | 0 | 0 | 0 | 0 | 0 | 0 | 0 | 0 | Y | Y | 0 | 1
SBFROMIMM | 0 | 0 | 0 | 0 | 0 | 1 | 1 | X | 0 | 0 | 0 | 0 | 0 | 0 | 0 | 0 | 0 | 0 | 0 | 1 | 0 | 1 | X | 0 | 0 | 1
SBFROMREG | 0 | 0 | 0 | 0 | 1 | 0 | 1 | X | 0 | 0 | 0 | 0 | 0 | 0 | 0 | 0 | 0 | 0 | 0 | 1 | 0 | 1 | X | 0 | 0 | 1
BEQ |  |  |  | 0 | 0 | X | X | X | 0 | 0 | 0 | 0 | 0 | 0 | 1 | 0 | 0 | 0 | 0 | 0 | X | X | X | 0 | 0 | 1
BNE |  |  |  | 0 | 0 | X | X | X | 0 | 0 | 0 | 0 | 0 | 0 | 0 | 0 | 0 | 0 | 1 | 0 | X | X | X | 0 | 0 | 1
BLT |  |  |  | 0 | 0 | X | X | X | 0 | 0 | 0 | 0 | 0 | 1 | 0 | 0 | 0 | 0 | 0 | 0 | X | X | X | 0 | 0 | 1
BGT |  |  |  | 0 | 0 | X | X | X | 0 | 0 | 0 | 0 | 0 | 0 | 0 | 1 | 0 | 0 | 0 | 0 | X | X | X | 0 | 0 | 1
BGE |  |  |  | 0 | 0 | X | X | X | 0 | 0 | 0 | 0 | 0 | 0 | 0 | 0 | 0 | 1 | 0 | 0 | X | X | X | 0 | 0 | 1
BLE |  |  |  | 0 | 0 | X | X | X | 0 | 0 | 0 | 0 | 0 | 0 | 0 | 0 | 1 | 0 | 0 | 0 | X | X | X | 0 | 0 | 1
PRINTREG | 0 | 0 | 0 | 0 | 1 | X | X | X | 0 | 0 | 0 | 0 | 0 | 0 | 0 | 0 | 0 | 0 | 0 | 0 | X | X | X | 0 | 0 | 1
PRINTREGANDLOAD | 0 | 0 | 0 | 0 | 1 | X | X | X | 0 | 0 | 0 | 0 | 0 | 0 | 0 | 0 | 0 | 0 | 0 | 0 | X | X | X | 0 | 0 | 1
PRINTMEMFROMREG | 0 | 0 | 0 | 0 | 0 | X | 0 | X | 0 | 0 | 0 | 0 | 0 | 0 | 0 | 0 | 0 | 0 | 0 | 1 | 1 | 0 | 1 | 1 | 0 | 1
PRINTMEMFROMIMM | 0 | 0 | 0 | 0 | 1 | X | 0 | X | 0 | 0 | 0 | 0 | 0 | 0 | 0 | 0 | 0 | 0 | 0 | 1 | 1 | 0 | 1 | 1 | 0 | 1
WRITETOREG | 0 | 0 | 0 | 0 | X | X | X | X | 0 | 0 | 0 | 0 | 0 | 0 | 0 | 0 | 0 | 0 | 0 | 0 | X | X | X | 0 | 1 | 0
WRITETOMEMFROMREG | 0 | 0 | 0 | 0 | 0 | X | 0 | X | 0 | 0 | 0 | 0 | 0 | 0 | 0 | 0 | 0 | 0 | 0 | 1 | 0 | 1 | 0 | 1 | 1 | 0
WRITETOMEMFROMIMM | 0 | 0 | 0 | 0 | 1 | X | 0 | X | 0 | 0 | 0 | 0 | 0 | 0 | 0 | 0 | 0 | 0 | 0 | 1 | 0 | 1 | 0 | 1 | 1 | 0

Sheet: KARNOUGH_V2
Karnough Map |  |  | Counter | Branch Register |  | IMMTO BUS BUFFER | REGOR IMM1 | REG_OR_ IMM2 |  | Memory |  |  | MEM_BUS BUFFER |  | REGISTER BLOK | Alu |  |  |  |  |  |  |  |  |  |  |  | REGISTER DECODER | Input Output
 |  |  | SLC | E | BUF BRNC | E | SLC | SLC | E-MEM D | E | R | W | E | IN/OUT | CLEAR | ADD/ SUB | BUFF ADD/SUB | BUF AND | BUF OR | BUF SR | BUF SL | LESS | EQ | BIG GER | LESS EQ | BIG EQ | NOT EQ | ISCLEAR SRC1 | ENABLE IN | LCD/D
 | Komut | Kontrol Ünitesi Kodu
1 | ADD | 0000000 | 0 | 0 | 0 | 1 | 0 | X | X | 0 | X | X | 0 | X | 0 | 0 | 1 | 0 | 0 | 0 | 0 | 0 | 0 | 0 | 0 | 0 | 0 | 0 | X | 0
2 | ADDIMM | 0000001 | 0 | 0 | 0 | 1 | 1 | X | X | 0 | X | X | 0 | X | 0 | 0 | 1 | 0 | 0 | 0 | 0 | 0 | 0 | 0 | 0 | 0 | 0 | 0 | X | 0
3 | SUB | 0000010 | 0 | 0 | 0 | 1 | 0 | X | X | 0 | X | X | 0 | X | 0 | 1 | 1 | 0 | 0 | 0 | 0 | 0 | 0 | 0 | 0 | 0 | 0 | 0 | X | 0
4 | SUBIMM | 0000011 | 0 | 0 | 0 | 1 | 1 | X | X | 0 | X | X | 0 | X | 0 | 1 | 1 | 0 | 0 | 0 | 0 | 0 | 0 | 0 | 0 | 0 | 0 | 0 | X | 0
5 | AND | 0000100 | 0 | 0 | 0 | 1 | 0 | X | X | 0 | X | X | 0 | X | 0 | X | 0 | 1 | 0 | 0 | 0 | 0 | 0 | 0 | 0 | 0 | 0 | 0 | X | 0
6 | ANDIMM | 0000101 | 0 | 0 | 0 | 1 | 1 | X | X | 0 | X | X | 0 | X | 0 | X | 0 | 1 | 0 | 0 | 0 | 0 | 0 | 0 | 0 | 0 | 0 | 0 | X | 0
7 | OR | 0000110 | 0 | 0 | 0 | 1 | 0 | X | X | 0 | X | X | 0 | X | 0 | X | 0 | 0 | 1 | 0 | 0 | 0 | 0 | 0 | 0 | 0 | 0 | 0 | X | 0
8 | ORIMM | 0000111 | 0 | 0 | 0 | 1 | 1 | X | X | 0 | X | X | 0 | X | 0 | X | 0 | 0 | 1 | 0 | 0 | 0 | 0 | 0 | 0 | 0 | 0 | 0 | X | 0
9 | SHIFTLEFT | 0001000 | 0 | 0 | 0 | 1 | 0 | X | X | 0 | X | X | 0 | X | 0 | X | 0 | 0 | 0 | 0 | 1 | 0 | 0 | 0 | 0 | 0 | 0 | 0 | X | 0
10 | SHIFTRIGHT | 0001001 | 0 | 0 | 0 | 1 | 0 | X | X | 0 | X | X | 0 | X | 0 | X | 0 | 0 | 0 | 1 | 0 | 0 | 0 | 0 | 0 | 0 | 0 | 0 | X | 0
11 | IMMTOREG | 0001010 | 0 | 0 | 0 | 0 | X | X | X | 0 | X | X | 0 | X | 0 | X | 0 | 0 | 0 | 0 | 0 | 0 | 0 | 0 | 0 | 0 | 0 | 0 | X | 0
12 | MEMTOREG | 0001011 | 0 | 0 | 0 | 1 | 1 | X | 0 | 1 | 1 | 0 | 1 | 1 | 0 | X | 0 | 0 | 0 | 0 | 0 | 0 | 0 | 0 | 0 | 0 | 0 | 0 | X | 0
13 | REGTOREG | 0001100 | 0 | 0 | 0 | 1 | X | 0 | 1 | 0 | X | X | 1 | 1 | 0 | X | 0 | 0 | 0 | 0 | 0 | 0 | 0 | 0 | 0 | 0 | 0 | 0 | X | 0
14 | REGTOMEM | 0001101 | 0 | 0 | 0 | 1 | 1 | 0 | 1 | 1 | 0 | 1 | 1 | 0 | 0 | X | 0 | 0 | 0 | 0 | 0 | 0 | 0 | 0 | 0 | 0 | 0 | 0 | X | 0
15 | BEQ | 0001110 | 1 | 1 | 1 | 1 | 0 | X | X | 0 | X | X | 0 | X | 0 | X | 0 | 0 | 0 | 0 | 0 | 0 | 1 | 0 | 0 | 0 | 0 | 0 | X | 0
16 | BNE | 0001111 | 1 | 1 | 1 | 1 | 0 | X | X | 0 | X | X | 0 | X | 0 | X | 0 | 0 | 0 | 0 | 0 | 0 | 0 | 0 | 0 | 0 | 1 | 0 | X | 0
17 | BLT | 0010000 | 1 | 1 | 1 | 1 | 0 | X | X | 0 | X | X | 0 | X | 0 | X | 0 | 0 | 0 | 0 | 0 | 1 | 0 | 0 | 0 | 0 | 0 | 0 | X | 0
18 | BGT | 0010001 | 1 | 1 | 1 | 1 | 0 | X | X | 0 | X | X | 0 | X | 0 | X | 0 | 0 | 0 | 0 | 0 | 0 | 0 | 1 | 0 | 0 | 0 | 0 | X | 0
19 | BGE | 0010010 | 1 | 1 | 1 | 1 | 0 | X | X | 0 | X | X | 0 | X | 0 | X | 0 | 0 | 0 | 0 | 0 | 0 | 0 | 0 | 0 | 1 | 0 | 0 | X | 0
20 | BLE | 0010011 | 1 | 1 | 1 | 1 | 0 | X | X | 0 | X | X | 0 | X | 0 | X | 0 | 0 | 0 | 0 | 0 | 0 | 0 | 0 | 1 | 0 | 0 | 0 | X | 0
21 | PRINTREG | 0010100 | 0 | 0 | 0 | 1 | X | 0 | 1 | 0 | X | X | 1 | 1 | 0 | X | 0 | 0 | 0 | 0 | 0 | 0 | 0 | 0 | 0 | 0 | 0 | 0 | 0 | 1
22 | IMMTOPRINTMEM | 0010101 | 0 | 0 | 0 | 1 | 1 | X | 0 | 1 | 1 | 0 | 1 | 1 | 0 | X | 0 | 0 | 0 | 0 | 0 | 0 | 0 | 0 | 0 | 0 | 0 | 0 | 0 | 1
23 | WRITEREG | 0010110 | 0 | 0 | 0 | 1 | X | X | X | 0 | X | X | 0 | X | 0 | X | 0 | 0 | 0 | 0 | 0 | 0 | 0 | 0 | 0 | 0 | 0 | 0 | 1 | 0
24 | IMMTOWRITEMEM | 0010111 | 0 | 0 | 0 | 1 | 1 | X | 0 | 1 | 0 | 1 | 1 | 0 | 0 | X | 0 | 0 | 0 | 0 | 0 | 0 | 0 | 0 | 0 | 0 | 0 | 0 | 1 | 0
25 | CLEARALLREG | 0011000 | 0 | 0 | 0 | 1 | X | X | X | 0 | X | X | 0 | X | 1 | X | 0 | 0 | 0 | 0 | 0 | 0 | 0 | 0 | 0 | 0 | 0 | 0 | x | 0
26 | CLEARSPECREG | 0011001 | 0 | 0 | 0 | 1 | X | X | X | 0 | X | X | 0 | X | 0 | X | 0 | 0 | 0 | 0 | 0 | 0 | 0 | 0 | 0 | 0 | 0 | 1 | x | 0
 |  |  | (x1 · |x2 · |x3) + (x2 · x3 · x4) | (x1 · |x2 · |x3) + (x2 · x3 · x4) | (x1 · |x2 · |x3) + (x2 · x3 · x4) | x5 + x3 + |x4 + |x2 | (x5 · ((x2 · |x3 · x4) + (|x1 · |x2))) + ((x3 · x5) · (x1 + |x4)) | 0 | (|x1 · x3) + |x5 | ((x2 · x5) · ((|x3 · x4) + (x3 · |x4))) + (x1 · x3 · x5) | x5 · ((|x2 · |x4) + |x3) | ((x3 · x5) · (|x1 + x4)) | ((x1 · x3) · (x5 + |x4)) + (x2 · |x3 · x4 · x5) + (x2 · x3 · |x4) | |x5 + (|x2 · |x4) + |x3 | (x1 · x2 · |x5) | 1 | (|x1 · |x2 · |x3) | (|x1 · |x2 · x3 · |x4) | (|x1 · |x2 · x3 · x4) | (|x1 · x2 · |x3 · |x4 · x5) | (|x1 · x2 · |x3 · |x4 · |x5) | (x1 · |x2 · |x3 · |x4 · |x5) | (x2 · x3 · x4 · |x5) | (x1 · |x2 · |x3 · |x4 · x5) | (x1 · |x3 · x4 · x5) | (x1 · |x3 · x4 · |x5) | (x2 · x3 · x4 · x5) | (x1 · x2 · x5) | x4 | (x1 · x3 · |x4)

Sheet: Sonuç Raporunda taslakları
 | Proje Öneri Formundaki |  |  | Son hali |  | Değişiklik
 | Komut | Açıklama |  | Komut | Açıklama
1 | ADD | İki kaydedicideki veriyi toplar | 1 | ADD | İki kaydedicideki veriyi toplar | -
2 | ADDIMM | Bir kaydedicideki veri ile anlık değeri toplar | 2 | ADDIMM | İlk kaydedicideki veri ile anlık değeri toplar | -
3 | SUB | İki kaydedicideki veriyi çıkarır | 3 | SUB | İlk kaydediciden ikinci kaydediciyi çıkarır. | -
4 | SUBIMM | Bir kaydedicideki veriden anlık değeri çıkarır | 4 | SUBIMM | İlk kaydedicideki veriden anlık değeri çıkarır | -
5 | AND | İki kaydedicideki verileri VE işlemine sokar | 5 | AND | İki kaydedicideki verileri VE işlemine sokar | -
6 | ANDIMM | Bir kaydedicideki veri ile anlık değeri VE işlemine sokar | 6 | ANDIMM | İlk kaydedicideki veri ile anlık değeri VE işlemine sokar | -
7 | OR | İki kaydedicideki verileri VEYA işlemine sokar | 7 | OR | İki kaydedicideki verileri VEYA işlemine sokar | -
8 | ORIMM | Bir kaydedicideki veri ile anlık değeri VEYA işlemine sokar | 8 | ORIMM | İki kaydedicideki veri ile anlık değeri VEYA işlemine sokar | -
9 | SHIFTLEFT | Bir kaydedicideki veriyi bir BİT sola kaydırır | 9 | SHIFTLEFT | İlk kaydedicideki veriyi bir BİT sola kaydırır | -
10 | SHIFTRIGHT | Bir kaydedicideki veriyi bir BİT sağa kaydırı | 10 | SHIFTRIGHT | İlk kaydedicideki veriyi bir BİT sağa kaydırı | -
11 | LBFROMIMM | Anlık değerden aldığı veriyi hedef kaydediciye yükler | 11 | IMMTOREG | Anlık değerden aldığı veriyi hedef kaydediciye yükler | Adı Değiştirildi
12 | LBFROMMEM | Hafızadan aldığı veriyi hedef kaydediciye yükler, Hafıza adreslerken anlık değeri kullanır | 12 | MEMTOREG | Hafızadan aldığı veriyi hedef kaydediciye yükler, Hafıza adreslerken anlık değeri kullanır | Adı Değiştirildi
13 | REGTOREG | Bir kaydedicideki veriyi başka bir kaydediciye aktarır, yükler | 13 | REGTOREG | İlk kaydedicideki veriyi hedef kaydediciye aktarır | -
14 | SBFROMIMM | Bir kaydedicideki veriyi adres olarak kullanır ve hafıza birimine anlık değeri yazar |  |  |  | Kaldırıldı
15 | SBFROMREG | Anlık değerdeki veriyi adres olarak kullanır ve hafıza birimine kaydedicideki veriyi yazar | 14 | REGTOMEM | Anlık değerdeki veriyi adres olarak kullanır ve hafıza birimine ilk kaydedicideki veriyi yazar | Adı Değiştirildi
16 | BEQ | İki kaydedicideki verinin eşit olma durumunu karşılaştırır. Eğer eşitse anlık değer kadar komut atlar | 15 | BEQ | İki kaydedicideki verinin eşit olma durumunu karşılaştırır. Eğer eşitse anlık değer kadar komut atlar | -
17 | BNE | İki kaydedicideki verinin eeşit olmama durumunu karşılaştırır. Eşit değilse anlık değer kadar komut atlar | 16 | BNE | İki kaydedicideki verinin eeşit olmama durumunu karşılaştırır. Eşit değilse anlık değer kadar komut atlar | -
18 | BLT | Birinci kaydedicideki verinin ikinci kaydedicideki veriden küçük olma durumunu karşılaştırır. Eğer büyükse, anlık değer kadar komut atlar | 17 | BLT | Birinci kaydedicideki verinin ikinci kaydedicideki veriden küçük olma durumunu karşılaştırır. Eğer büyükse, anlık değer kadar komut atlar | -
19 | BGT | Birinci kaydedicideki verinin ikinci kaydedicideki veriden büyük olma durumunu karşılaştırır. Eğer büyükse, anlık değer kadar komut atlar | 18 | BGT | Birinci kaydedicideki verinin ikinci kaydedicideki veriden büyük olma durumunu karşılaştırır. Eğer büyükse, anlık değer kadar komut atlar | -
20 | BGE | Birinci kaydedicideki verinin ikinci kaydedicideki veriden büyük ve eşit olma durumunu karşılaştırır. Eğer büyük ve eşitse, anlık değer kadar komut atlar | 19 | BGE | Birinci kaydedicideki verinin ikinci kaydedicideki veriden büyük ve eşit olma durumunu karşılaştırır. Eğer büyük ve eşitse, anlık değer kadar komut atlar | -
21 | BLE | Birinci kaydedicideki verinin ikinci kaydedicideki veriden küçük ve eşit olma durumunu karşılaştırır. Eğer kü.ük ve eşit ise, anlık değer kadar komut atlar | 20 | BLE | Birinci kaydedicideki verinin ikinci kaydedicideki veriden küçük ve eşit olma durumunu karşılaştırır. Eğer kü.ük ve eşit ise, anlık değer kadar komut atlar | -
22 | PRINTREG | Bir kaydedicideki veriyi çıkış birimine gönderir | 21 | PRINTREG | İlk kaydedicideki veriyi çıkış birimine gönderir | -
23 | PRINTREGANDLOAD | Bir kaydedicideki veriyi çıkış birimine gönderir ve başka bir kaydediciye yükler |  |  |  | Kaldırıldı
24 | PRINTMEMFROMREG | Bir kaydedicideki veriyi adres olarak kullanır ve hafıza birimine gönderir. O adresdeki veriyi çıkış birimine gönderir |  |  |  | Kaldırıldı
25 | PRINTMEMFROMIMM | Anlık değeri adres olarak kullanır ve hafıza birimine gönderir. O adresdeki veriyi çıkış birimine gönderir | 22 | IMMTOPRINTMEM | Anlık değeri adres olarak kullanır ve hafıza birimine gönderir. O adresdeki veriyi çıkış birimine gönderir | Adı Değiştirildi
26 | WRITETOREG | Giriş biriminden gelen veriyi bir kaydediciye yükler | 23 | WRITEREG | Giriş biriminden gelen veriyi bir kaydediciye yükler | Adı Değiştirildi
27 | WRITETOMEMFROMREG | Bir kaydedicideki veriyi adres olarak kullanır ve giriş biriminden gelen veriyi hafıza birimine yükler | 24 |  |  | Kaldırıldı
28 | WRITETOMEMFROMIMM | Anlık değerden aldığı veriyi adres olarak kullanır ve giriş biriminden aldığı veriyi hafıza birimine yükler | 25 | IMMTOWRITEMEM | Anlık değerden aldığı veriyi adres olarak kullanır ve giriş biriminden aldığı veriyi hafıza birimine yükler | Adı Değiştirildi
 |  |  | 26 | CLEARALLREG | Tüm kaydedicilerin verilerini sıfırlar | Eklendi
 |  |  | 27 | CLEARSPECREG | İlgili kaydedicinin verisini siler | Eklendi

Sheet: Sheet1
 |  | 7 BİT | 3BİT | 3 BİT | 3 BİT | 8 BİT
 | Komut | Kontrol Ünitesi Kodu | HY | KY1 | KY2 | Anlık Değer | Açıklama
1 | ADD | 0000001 | √ | √ | √ | X | HY = KY1 + KY2
2 | ADDIMM | 0000010 | √ | √ | X | √ | HY = KY1 + ANLIK
3 | SUB | 0000011 | √ | √ | √ | X | HY = KY1 – KY2
4 | SUBIMM | 0000100 | √ | √ | X | √ | HY = KY1 – ANLIK
5 | AND | 0000101 | √ | √ | √ | X | HY = KY1 && KY2
6 | ANDIMM | 0000110 | √ | √ | X | √ | HY = KY1 && ANLIK
7 | OR | 0000111 | √ | √ | √ | X | HY = KY1 || KY2
8 | ORIMM | 0001000 | √ | √ | X | √ | HY = KY1 || ANLIK
9 | SHIFTLEFT | 0001001 | √ | √ | X | X | HY = KY1[0:6]
10 | SHIFTRIGHT | 0001010 | √ | √ | X | X | HY = KY1[1:7]
11 | IMMTOREG | 0001011 | √ | X | X | √ | HY = ANLIK
12 | MEMTOREG | 0001100 | √ | X | X | √ | HY = MEM(ANLIK)
13 | REGTOREG | 0001101 | √ | X | √ | X | HY = KY2
14 | REGTOMEM | 0001110 | X | √ | X | √ | MEM(ANLIK) = KY2
15 | BEQ | 0001111 | X | √ | √ | √ | IF KY1 == KY2 JUMP ANLIK
16 | BNE | 0010000 | X | √ | √ | √ | IF KY1 != KY2 JUMP ANLIK
17 | BLT | 0010001 | X | √ | √ | √ | IF KY1 < KY2 JUMP ANLIK
18 | BGT | 0010010 | X | √ | √ | √ | IF KY1 > KY2 JUMP ANLIK
19 | BGE | 0010011 | X | √ | √ | √ | IF KY1 >= KY2 JUMP ANLIK
20 | BLE | 0010100 | X | √ | √ | √ | IF KY1 <= KY2 JUMP ANLIK
21 | PRINTREG | 0010101 | X | X | √ | X | OUTPUT(KY2)
22 | IMMTOPRINTMEM | 0010110 | X | X | X | √ | OUTPUT(MEM(ANLIK))
23 | WRITEREG | 0010111 | √ | X | X | X | HY = INPUT
24 | IMMTOWRITEMEM | 0011000 | X | X | X | √ | MEM(ANLIK) = INPUT
25 | CLEARALLREG | 0011001 | X | X | X | X | ALLREG = 0
26 | CLEARSPECREG | 0011010 | X | √ | X | X | REG = 0

Sheet: Sheet2
 | (x5 · YYYY) + ((x3 · x5) · (x1 + |x4))
 | (|x1 · x3) + |x5
 | ((x2 · x5) · ((|x3 · x4) + (x3 · |x4))) + (x1 · x3 · x5)
 | x5 · ((|x2 · |x4) + |x3)
 | ((x3 · x5) · (|x1 + x4))
 | ((x1 · x3) · (x5 + |x4)) + (x2 · |x3 · x4 · x5) + (x2 · x3 · |x4)
 | |x5 + (|x2 · |x4) + |x3
 | (x1 · x2 · |x5)
 | (|x1 · |x2 · |x3)
 | (|x1 · |x2 · x3 · |x4)
 | (|x1 · |x2 · x3 · x4)
 | (|x1 · x2 · |x3 · |x4 · x5)
 | (|x1 · x2 · |x3 · |x4 · |x5)
 | (x1 · |x2 · |x3 · |x4 · |x5)
 | (x2 · x3 · x4 · |x5)
 | (x1 · |x2 · |x3 · |x4 · x5)
 | (x1 · |x3 · x4 · x5)
 | (x1 · |x3 · x4 · |x5)
0011010 | (x2 · x3 · x4 · x5)
 | (x1 · x2 · x5)
 | (x1 · x3 · |x4)
