MusaAkyuz/8bit-Computer/docs/design/Karnough.xlsx

Sheet: Sayfa1
Kaurnaugh Map | Counter | Branch Register |  | Immediatelly to Register | MUX1 REGTOIMM | MUX2 REGTOIMM2 |  | ALU |  |  |  |  |  |  |  |  |  |  |  | Memory |  |  | Memory Buffer |  | In/Out
Command/Inputs | SLC | E | BUFFBRNC | ITR | REGTOIMM1 | REFTOIMM2 | E-MEM-D | ADD/SUBB | BUFFADD/SUB | BUFAND | BUFOR | BUFSR | BUFSL | LESS | EQ | BIGGER | LESSEQ | BIGEQ | NOTEQ | E | R | W | MIN/MOUT | Enable Buf. | EnableIn | LCD/D
ADD | 0 | 0 | 0 | 0 | 0 | X | X | 0 | 1 | 0 | 0 | 0 | 0 | 0 | 0 | 0 | 0 | 0 | 0 | 0 | X | X | X | 0 | 0 | 1
ADDIMM | 0 | 0 | 0 | 0 | 1 | X | X | 0 | 1 | 0 | 0 | 0 | 0 | 0 | 0 | 0 | 0 | 0 | 0 | 0 | X | X | X | 0 | 0 | 1
SUB | 0 | 0 | 0 | 0 | 0 | X | X | 1 | 1 | 0 | 0 | 0 | 0 | 0 | 0 | 0 | 0 | 0 | 0 | 0 | X | X | X | 0 | 0 | 1
SUBIMM | 0 | 0 | 0 | 0 | 1 | X | X | 1 | 1 | 0 | 0 | 0 | 0 | 0 | 0 | 0 | 0 | 0 | 0 | 0 | X | X | X | 0 | 0 | 1
AND | 0 | 0 | 0 | 0 | 0 | X | X | X | 0 | 1 | 0 | 0 | 0 | 0 | 0 | 0 | 0 | 0 | 0 | 0 | X | X | X | 0 | 0 | 1
ANDIMM | 0 | 0 | 0 | 0 | 1 | X | X | X | 0 | 1 | 0 | 0 | 0 | 0 | 0 | 0 | 0 | 0 | 0 | 0 | X | X | X | 0 | 0 | 1
OR | 0 | 0 | 0 | 0 | 0 | X | X | X | 0 | 0 | 1 | 0 | 0 | 0 | 0 | 0 | 0 | 0 | 0 | 0 | X | X | X | 0 | 0 | 1
ORIMM | 0 | 0 | 0 | 0 | 1 | X | X | X | 0 | 0 | 1 | 0 | 0 | 0 | 0 | 0 | 0 | 0 | 0 | 0 | X | X | X | 0 | 0 | 1
SHIFTLEFT | 0 | 0 | 0 | 0 | 0 | X | X | X | 0 | 0 | 0 | 0 | 1 | 0 | 0 | 0 | 0 | 0 | 0 | 0 | X | X | X | 0 | 0 | 1
SHIFTRIGHT | 0 | 0 | 0 | 0 | 0 | X | X | X | 0 | 0 | 0 | 1 | 0 | 0 | 0 | 0 | 0 | 0 | 0 | 0 | X | X | X | 0 | 0 | 1
LBFROMIMM | 0 | 0 | 0 | 1 | X | X | X | X | 0 | 0 | 0 | 0 | 0 | 0 | 0 | 0 | 0 | 0 | 0 | 0 | X | X | X | 0 | 0 | 1
LBFROMMEM | 0 | 0 | 0 | 0 | 1 | X | 0 | X | 0 | 0 | 0 | 0 | 0 | 0 | 0 | 0 | 0 | 0 | 0 | 1 | 1 | 0 | 1 | 1 | 0 | 1
REGTOREG | 0 | 0 | 0 | 0 | 1 | J | J | X | 0 | 0 | 0 | 0 | 0 | 0 | 0 | 0 | 0 | 0 | 0 | 0 | 0 | 0 | Y | Y | 0 | 1
SBFROMIMM | 0 | 0 | 0 | 0 | 0 | 1 | 1 | X | 0 | 0 | 0 | 0 | 0 | 0 | 0 | 0 | 0 | 0 | 0 | 1 | 0 | 1 | X | 0 | 0 | 1
SBFROMREG | 0 | 0 | 0 | 0 | 1 | 0 | 1 | X | 0 | 0 | 0 | 0 | 0 | 0 | 0 | 0 | 0 | 0 | 0 | 1 | 0 | 1 | X | 0 | 0 | 1
BEQ |  |  |  | 0 | 0 | X | X | X | 0 | 0 | 0 | 0 | 0 | 0 | 1 | 0 | 0 | 0 | 0 | 0 | X | X | X | 0 | 0 | 1
BNE |  |  |  | 0 | 0 | X | X | X | 0 | 0 | 0 | 0 | 0 | 0 | 0 | 0 | 0 | 0 | 1 | 0 | X | X | X | 0 | 0 | 1
BLT |  |  |  | 0 | 0 | X | X | X | 0 | 0 | 0 | 0 | 0 | 1 | 0 | 0 | 0 | 0 | 0 | 0 | X | X | X | 0 | 0 | 1
BGT |  |  |  | 0 | 0 | X | X | X | 0 | 0 | 0 | 0 | 0 | 0 | 0 | 1 | 0 | 0 | 0 | 0 | X | X | X | 0 | 0 | 1
BGE |  |  |  | 0 | 0 | X | X | X | 0 | 0 | 0 | 0 | 0 | 0 | 0 | 0 | 0 | 1 | 0 | 0 | X | X | X | 0 | 0 | 1
BLE |  |  |  | 0 | 0 | X | X | X | 0 | 0 | 0 | 0 | 0 | 0 | 0 | 0 | 1 | 0 | 0 | 0 | X | X | X | 0 | 0 | 1
PRINTREG | 0 | 0 | 0 | 0 | 1 | X | X | X | 0 | 0 | 0 | 0 | 0 | 0 | 0 | 0 | 0 | 0 | 0 | 0 | X | X | X | 0 | 0 | 1
PRINTREGANDLOAD | 0 | 0 | 0 | 0 | 1 | X | X | X | 0 | 0 | 0 | 0 | 0 | 0 | 0 | 0 | 0 | 0 | 0 | 0 | X | X | X | 0 | 0 | 1
PRINTMEMFROMREG | 0 | 0 | 0 | 0 | 0 | X | 0 | X | 0 | 0 | 0 | 0 | 0 | 0 | 0 | 0 | 0 | 0 | 0 | 1 | 1 | 0 | 1 | 1 | 0 | 1
PRINTMEMFROMIMM | 0 | 0 | 0 | 0 | 1 | X | 0 | X | 0 | 0 | 0 | 0 | 0 | 0 | 0 | 0 | 0 | 0 | 0 | 1 | 1 | 0 | 1 | 1 | 0 | 1
WRITETOREG | 0 | 0 | 0 | 0 | X | X | X | X | 0 | 0 | 0 | 0 | 0 | 0 | 0 | 0 | 0 | 0 | 0 | 0 | X | X | X | 0 | 1 | 0
WRITETOMEMFROMREG | 0 | 0 | 0 | 0 | 0 | X | 0 | X | 0 | 0 | 0 | 0 | 0 | 0 | 0 | 0 | 0 | 0 | 0 | 1 | 0 | 1 | 0 | 1 | 1 | 0
WRITETOMEMFROMIMM | 0 | 0 | 0 | 0 | 1 | X | 0 | X | 0 | 0 | 0 | 0 | 0 | 0 | 0 | 0 | 0 | 0 | 0 | 1 | 0 | 1 | 0 | 1 | 1 | 0

Sheet: Sayfa2
Command/Inputs | SLC | E | BUFFBRNC | ITR | REGTOIMM1 | REFTOIMM2 | E-MEM-D | ADD/SUBB | BUFFADD/SUB | BUFAND | BUFOR | BUFSR | BUFSL | LESS | EQ | BIGGER | LESSEQ | BIGEQ | NOTEQ | E | R | W | MIN/MOUT | Enable Buf.
ADD | 0 | 0 | 0 | 0 | 0 | X | X | 0 | 1 | 0 | 0 | 0 | 0 | 0 | 0 | 0 | 0 | 0 | 0 | 0 | X | X | X | 0
ADDIMM | 0 | 0 | 0 | 0 | 1 | X | X | 0 | 1 | 0 | 0 | 0 | 0 | 0 | 0 | 0 | 0 | 0 | 0 | 0 | X | X | X | 0
SUB | 0 | 0 | 0 | 0 | 0 | X | X | 1 | 1 | 0 | 0 | 0 | 0 | 0 | 0 | 0 | 0 | 0 | 0 | 0 | X | X | X | 0
SUBIMM | 0 | 0 | 0 | 0 | 1 | X | X | 1 | 1 | 0 | 0 | 0 | 0 | 0 | 0 | 0 | 0 | 0 | 0 | 0 | X | X | X | 0
AND | 0 | 0 | 0 | 0 | 0 | X | X | X | 0 | 1 | 0 | 0 | 0 | 0 | 0 | 0 | 0 | 0 | 0 | 0 | X | X | X | 0
ANDIMM | 0 | 0 | 0 | 0 | 1 | X | X | X | 0 | 1 | 0 | 0 | 0 | 0 | 0 | 0 | 0 | 0 | 0 | 0 | X | X | X | 0
OR | 0 | 0 | 0 | 0 | 0 | X | X | X | 0 | 0 | 1 | 0 | 0 | 0 | 0 | 0 | 0 | 0 | 0 | 0 | X | X | X | 0
ORIMM | 0 | 0 | 0 | 0 | 1 | X | X | X | 0 | 0 | 1 | 0 | 0 | 0 | 0 | 0 | 0 | 0 | 0 | 0 | X | X | X | 0
SHIFTLEFT | 0 | 0 | 0 | 0 | 0 | X | X | X | 0 | 0 | 0 | 0 | 1 | 0 | 0 | 0 | 0 | 0 | 0 | 0 | X | X | X | 0
SHIFTRIGHT | 0 | 0 | 0 | 0 | 0 | X | X | X | 0 | 0 | 0 | 1 | 0 | 0 | 0 | 0 | 0 | 0 | 0 | 0 | X | X | X | 0
LBFROMIMM | 0 | 0 | 0 | 1 | X | X | X | X | 0 | 0 | 0 | 0 | 0 | 0 | 0 | 0 | 0 | 0 | 0 | 0 | X | X | X | 0
LBFROMMEM | 0 | 0 | 0 | 0 | 1 | X | 0 | X | 0 | 0 | 0 | 0 | 0 | 0 | 0 | 0 | 0 | 0 | 0 | 1 | 1 | 0 | 1 | 1
SBFROMIMM | 0 | 0 | 0 | 0 | 0 | 1 | 1 | X | 0 | 0 | 0 | 0 | 0 | 0 | 0 | 0 | 0 | 0 | 0 | 1 | 0 | 1 | X | 0
SBFROMREG | 0 | 0 | 0 | 0 | 1 | 0 | 1 | X | 0 | 0 | 0 | 0 | 0 | 0 | 0 | 0 | 0 | 0 | 0 | 1 | 0 | 1 | X | 0
BEQ |  |  |  | 0 | 0 | X | X | X | 0 | 0 | 0 | 0 | 0 | 0 | 1 | 0 | 0 | 0 | 0 | 0 | X | X | X | 0
BNE |  |  |  | 0 | 0 | X | X | X | 0 | 0 | 0 | 0 | 0 | 0 | 0 | 0 | 0 | 0 | 1 | 0 | X | X | X | 0
BLT |  |  |  | 0 | 0 | X | X | X | 0 | 0 | 0 | 0 | 0 | 1 | 0 | 0 | 0 | 0 | 0 | 0 | X | X | X | 0
BGT |  |  |  | 0 | 0 | X | X | X | 0 | 0 | 0 | 0 | 0 | 0 | 0 | 1 | 0 | 0 | 0 | 0 | X | X | X | 0
BGE |  |  |  | 0 | 0 | X | X | X | 0 | 0 | 0 | 0 | 0 | 0 | 0 | 0 | 0 | 1 | 0 | 0 | X | X | X | 0
BLE |  |  |  | 0 | 0 | X | X | X | 0 | 0 | 0 | 0 | 0 | 0 | 0 | 0 | 1 | 0 | 0 | 0 | X | X | X | 0
PRINTREG | 0 | 0 | 0 | 0 | 1 | X | X | X | 0 | 0 | 0 | 0 | 0 | 0 | 0 | 0 | 0 | 0 | 0 | 0 | X | X | X | 0
PRINTREGANDLOAD | 0 | 0 | 0 | 0 | 1 | X | X | X | 0 | 0 | 0 | 0 | 0 | 0 | 0 | 0 | 0 | 0 | 0 | 0 | X | X | X | 0
PRINTMEMFROMREG | 0 | 0 | 0 | 0 | 0 | X | 0 | X | 0 | 0 | 0 | 0 | 0 | 0 | 0 | 0 | 0 | 0 | 0 | 1 | 1 | 0 | 1 | 1
PRINTMEMFROMIMM | 0 | 0 | 0 | 0 | 1 | X | 0 | X | 0 | 0 | 0 | 0 | 0 | 0 | 0 | 0 | 0 | 0 | 0 | 1 | 1 | 0 | 1 | 1
WRITETOREG | 0 | 0 | 0 | 0 | X | X | X | X | 0 | 0 | 0 | 0 | 0 | 0 | 0 | 0 | 0 | 0 | 0 | 0 |  |  | X | 0
WRITETOMEMFROMREG | 0 | 0 | 0 | 0 | 0 | X | 0 | X | 0 | 0 | 0 | 0 | 0 | 0 | 0 | 0 | 0 | 0 | 0 | 1 | 0 | 1 | 0 | 1
WRITETOMEMFROMIMM | 0 | 0 | 0 | 0 | 1 | X | 0 | X | 0 | 0 | 0 | 0 | 0 | 0 | 0 | 0 | 0 | 0 | 0 | 1 | 0 | 1 | 0 | 1
