MusaAkyuz/8bit-Computer/(list of files, drawings)

Other design files:
hardware/01-building-blocks/3to8decoder.pdsprj
hardware/01-building-blocks/4-bit-mux-selector.pdsprj
hardware/01-building-blocks/8-bit-comparator.pdsprj
hardware/01-building-blocks/8-bit-register.pdsprj
hardware/01-building-blocks/Buffer.pdsprj
hardware/01-building-blocks/full-adder-and-sub.pdsprj
hardware/01-building-blocks/program-counter-final.pdsprj
hardware/01-building-blocks/program-counter-trying-2.pdsprj
hardware/01-building-blocks/program-counter-trying.pdsprj
hardware/01-building-blocks/program-counter.pdsprj
hardware/01-building-blocks/single-pulse-generator-for-memory.pdsprj
hardware/03-revision-2023/8BitProcessor.pdsprj
hardware/03-revision-2023/ControlBlock.pdsprj
hardware/04-final-2024/8BitProcessor.pdsprj
