MusaAkyuz/8bit-Computer/(commit log)

2023-05-02 Control Unit Design and some updates
    [8BitProcessor [20230430, 04-42-34].pdsprj, 8BitProcessor [20230430, 04-53-10].pdsprj, 8BitProcessor [20230502, 04-19-04].pdsprj, 8BitProcessor [20230502, 14-34-09].pdsprj, 8BitProcessor.pdsprj, ControlBlock [20230502, 09-18-33].pdsprj, ControlBlock [20230502, 14-34-19].pdsprj, ControlBlock.pdsprj]
2024-09-20 tasarım geliştirilmeleri eklendi ve tübitak sonuç raporu yazıldı
    [8BitProcessor [20240830, 15-07-02].pdsprj, 8BitProcessor [20240902, 04-10-58].pdsprj, 8BitProcessor [20240903, 21-40-09].pdsprj, 8BitProcessor [20240903, 21-40-11].pdsprj, 8BitProcessor [20240910, 22-36-57].pdsprj, 8BitProcessor [20240916, 06-34-26].pdsprj, 8BitProcessor [20240917, 08-37-38].pdsprj, 8BitProcessor [20240918, 07-01-52].pdsprj]
2026-08-10 chore: reorganize repository and remove generated/redundant files
    The repo had grown into a flat dump of ~250 files where design docs,
    Proteus circuits, datasheets and papers were mixed together, with
    three generations of the processor design indistinguishable from
    each other.
    Structure is now:
    docs/ report, paper drafts, design working files, figures
    hardware/ Proteus circuits, split by design generation:
    01-building-blocks, 02-prototype-2022,
    03-revision-2023, 04-final-2024
    datasheets/ component datasheets
    references/ cited papers and specs
    Removed (approved): Proteus auto-save backups (77 files), per-machine
    .workspace files (53), Proteus gene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
    [3to8decoder [20230417, 16-45-15].pdsprj, 3to8decoder.pdsprj, 4-bit-mux-selector [20230417, 16-44-58].pdsprj, 4-bit-mux-selector.pdsprj, 8-bit-comparator.pdsprj, 8-bit-register [20221011, 09-10-43].pdsprj, 8-bit-register [20230414, 13-42-37].pdsprj, 8-bit-register.pdsprj]
2026-08-10 docs: add detailed English README; normalize figure filenames
    Write a full technical README from the TUBITAK 2209-A final report:
    motivation, Harvard design rationale, 24-bit instruction format, the
    complete instruction set with opcodes and field usage, per-module
    walkthrough (register block, ALU, memory, counter, hardwired control
    unit and its Karnaugh derivation), and an honest results section
    covering what the Harvard/single-cycle trade actually cost and the
    missing assembler.
    Also rename figures from Turkish/spaced filenames to ASCII so the
    markdown image links resolve on GitHub, and note in the README where
    the report's own instruction counts contradict each other rather than
    picking o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
